LitaAndrew/InfoEducatie_2025/README.md

# InfoEducatie_2025

Proiectul „TerraTank” realizat de Deaconescu Alex Cristian și Liță Andrei Rareș.

Pentru realizarea proiectului, am împărțit sarcinile astfel:

-Deaconescu Alex Cristian a fost responsabil pentru construirea și proiectarea 3D a robotului;

-Liță Andrei Rareș pentru configurarea si programarea sa;
